punkrocker/Keyboards/README.md

# SweepPluck

34 键正交分体键盘，采用可翻面 PCB。两侧使用两片相同 PCB，在相反面装配。

本仓库仅包含 Pluck 版本。

- [工程、装配说明及验证结果](SweepPluck/README.txt)
- [主控焊接位置标记图](SweepPluck/mcu-guide/README.md)
- [电池与电源开关焊接图](SweepPluck/power-guide/README.md)
- [PCB 下单文件](SweepPluck/SweepPluck-JLCPCB.zip)
- [旅行便携盒](SweepPluck/travel-case/)
- [许可证](LICENSE)

设计基于 [Sweep](https://github.com/davidphilipbarr/Sweep)。Pluck 的历史设计归档保存在 `SweepPluck/archive/`。
