punkrocker/Keyboards/SweepPluck/travel-case/使用说明.txt

SweepPluck 旅行便携盒 — 裸 PCB / 3 mm 防滑垫修订版

设计依据
不使用键盘底壳，直接从当前 PCB 读取 95.25×80×1.6 mm 板框。
配置为 3 mm 防滑垫、Choc V2；按用户要求，用 Keychron K3 键帽高度替代原键帽模型。
采用 K3 兼容 LSA Version 1 键帽官方高度 4.4 mm：
https://www.keychron.com/products/low-profile-double-shot-pbt-keycap-set
这不是所有 K3 世代键帽的统一高度，也不是 Choc V2 与该键帽的适配验证。
主控：nice!nano，插座热插拔，按当前 PCB 说明元件面朝向 PCB（FACE DOWN）。
官方给出的模块总厚度为 3.2 mm：
https://nicekeyboards.com/docs/nice-nano/
插座具体型号尚未指定；设计暂以 PCB 上表面至模块最低外包络点 8.5 mm 的间距预算。
此数值不是排母本体高度，不等于实物安装距离；需包含实际引脚/插座造成的抬高。
按该预算，模块最高点距 PCB 上表面不超过 8.5+3.2=11.7 mm，
加 3 mm 垫和 1.6 mm PCB 后总高 16.3 mm，距 20 mm 腔顶余量 3.7 mm。
保留 1 mm 最低余量时，允许上述模块最低包络点间距最大 11.2 mm。
电池与接线如装在主控下方，须在同一空间内固定，不计为自动适配。

文件与尺寸（mm）
base.stl / lid.stl：上下半盒，合拢外形 108.05×92.80×44.80。
preview.png：几何预览。verification.json：来源、尺寸及网格检查。
foam_locator_1to1.svg：EVA 定位圈裁切模板，毫米单位，打印核对比例。
../tools/travel_case.py：生成器，不再依赖 case/ 的键盘底壳。
壁厚和底厚均 2.4，每半内腔 103.25×88，深度 20。
止口突出 1.6，径向配合间隙 0.30，净开口 100.25×85。
内腔比 PCB 每侧大 4 mm，接口实际外伸仍需核对。

内托与装配
用约 4 mm 厚 EVA 按模板制作两片环形内托，放在两半盒底。
外形约 102.85×87.60，内孔 96.05×80.80。
内孔容纳 PCB 及按板框裁切的 3 mm 防滑垫，每侧约 0.4 mm 间隙。
内托只属于收纳盒，不固定到键盘上；不需要打印键盘外壳。
不再额外叠加上一版的 1 mm 底垫。按软材料压缩情况试配，
可在 PCB 板边附近局部补薄软垫消除晃动，避让焊脚和接口。
防滑垫须绝缘，接触焊脚及轴体底部凸起的位置应开槽避让。
不要依赖强压软垫容纳凸起；确认凸起没有穿透防滑垫。
键盘防滑垫朝盒底，合拢时键帽相向；拔掉连接线后收纳。
另配 15～20 mm 宽魔术贴绑带。止口只定位，没有自锁功能。
开盒时扶住上半盒中的键盘；软内托不保证倒置锁住键盘。
软垫不可顶住键帽、主控、开关或接口；盒内不散放线材。

高度确认
测量从 3 mm 防滑垫底面至最高器件顶面的总高，包含主控及键帽。
本版高度预算：防滑垫 3 + PCB 1.6 + 轴体上方设计预留 10 + 键帽 4.4 = 19 mm。
10 mm 是保守的设计预留，不是厂商轴体尺寸；未扣除轴帽插接重叠量。
每半内腔 20 mm，预算余量各 1 mm，合拢面间余量合计至少 2 mm。
实际装配总高（含主控）须不超过 19 mm；主控最高点距 PCB 上表面须不超过 14.4 mm。
如超出，应加深盒子。最终腔深取实测总高加至少 1 mm。
键帽宽度、板边外伸、主控高度及接口外伸也需核对。
本版按授权的 K3 高度代理估算，尚未通过实物适配检查。

打印与重建
两件平底贴板、开口朝上、100% 比例，按实际打印机及耗材选预设。
起点：0.4 mm 喷嘴，0.20 mm 层高，4 道墙，5 层顶底，15～20% 填充。
检查止口根部约 1.5 mm 向内台阶桥接；一般无需支撑。
先试配止口，再打印完整件。STL 不包含已验证的切片配置。
从 D:/Projects/Sweep 执行：
python Sweep/SweepPluck/tools/travel_case.py --half-depth 20
--mcu-gap 8.5 可调整主控安装间距预算；超出高度余量时脚本要求加深盒子。
修改 half-depth 调整内部高度，覆盖模型、预览、裁切图及报告。
自定义参数后以 verification.json 为准，并同步更新本说明。

验证范围
两个模型均封闭、正体积、法向一致、单一连通；合盖相交体积为 0。
止口净开口大于 PCB 外形，未验证真实装配包围盒。
尚未实物试印，未验证指定轴帽、主控、接口、内托固定效果和抗压强度。
