punkrocker/Keyboards/SweepPluck/case/preview_trays.png

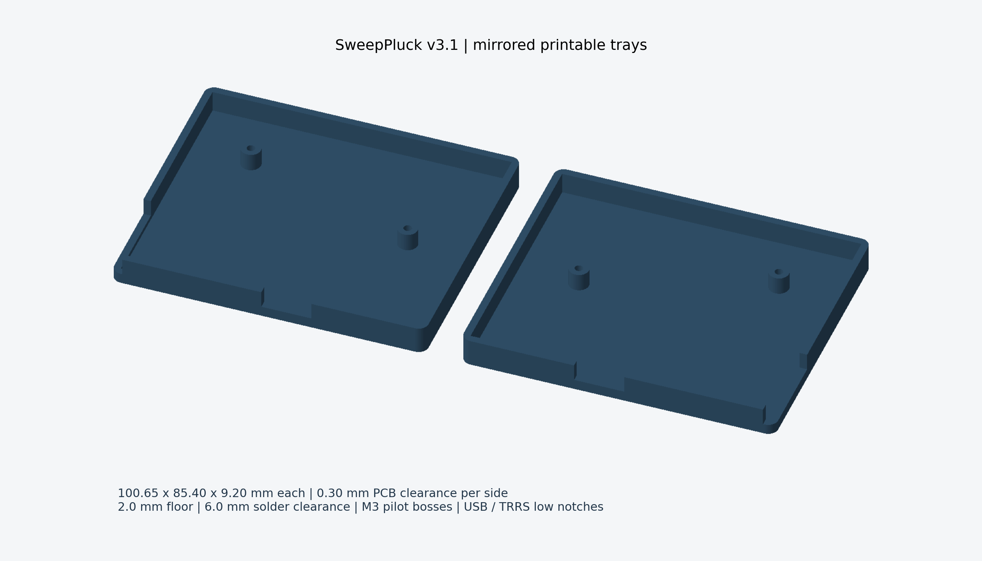
SweepPluck/case/preview_trays.png
