punkrocker/Keyboards/SweepPluck/SweepPluck-back-pcb.png

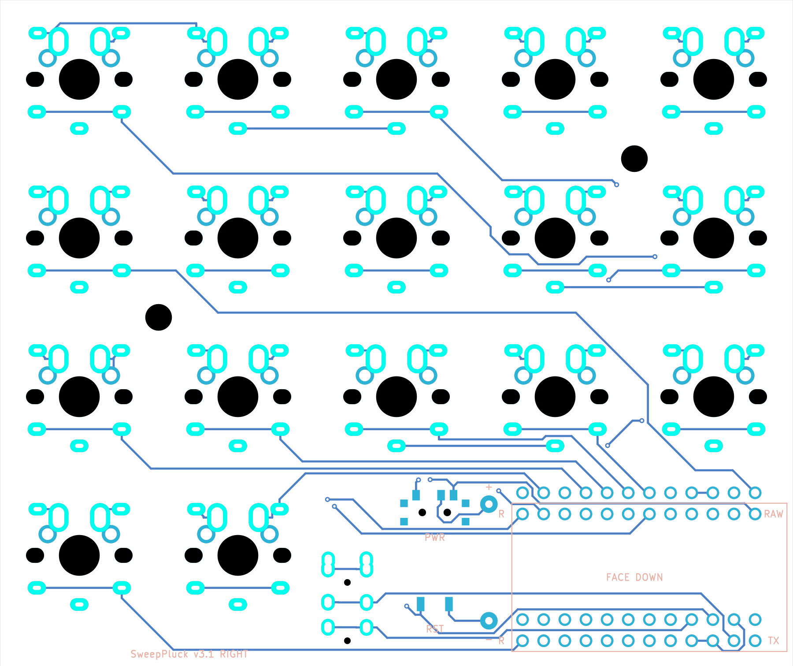
SweepPluck/SweepPluck-back-pcb.png
