punkrocker/Keyboards/SweepPluck/SweepPluck-plate-pcb.png

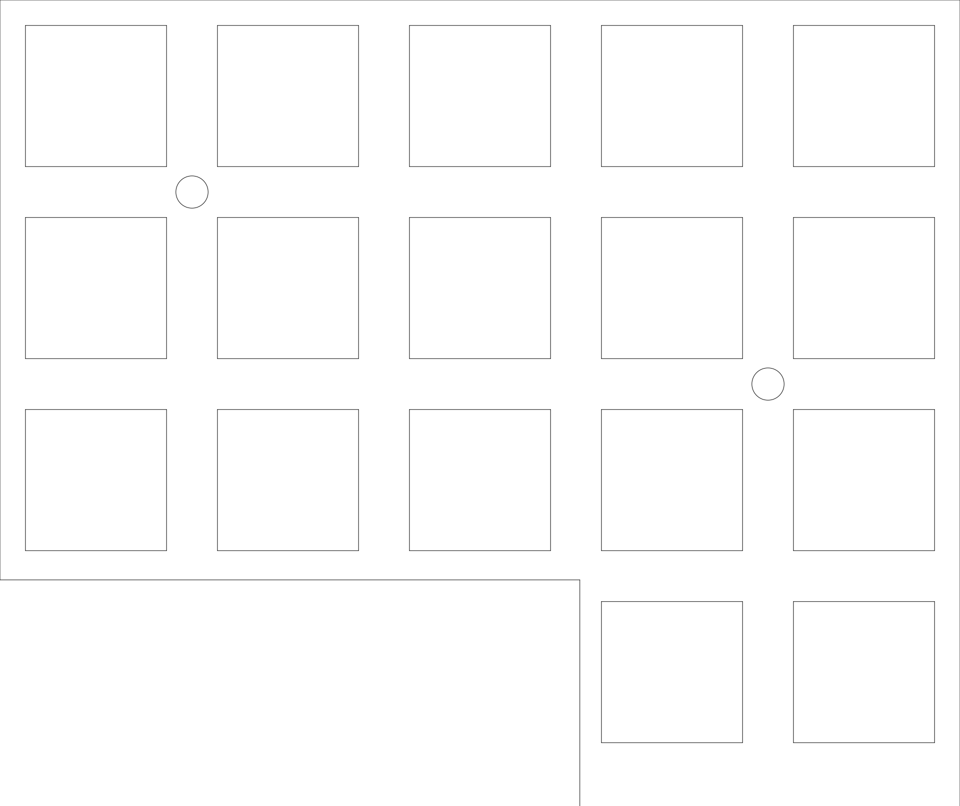
SweepPluck/SweepPluck-plate-pcb.png
