punkrocker/Keyboards/SweepPluck/SweepPluck-preview-pcb.png

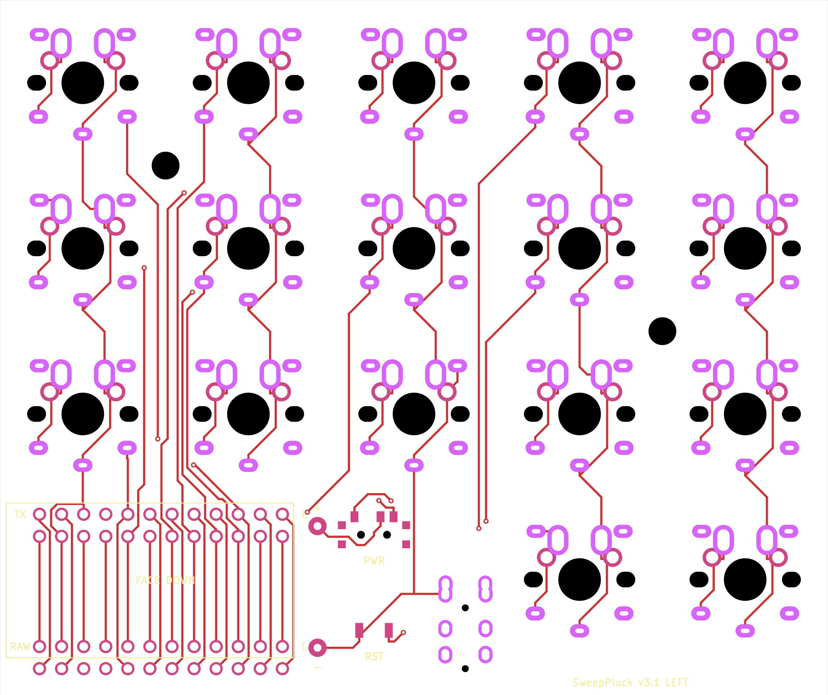
SweepPluck/SweepPluck-preview-pcb.png
