punkrocker/Keyboards/SweepPluck/SweepPluck-preview.png

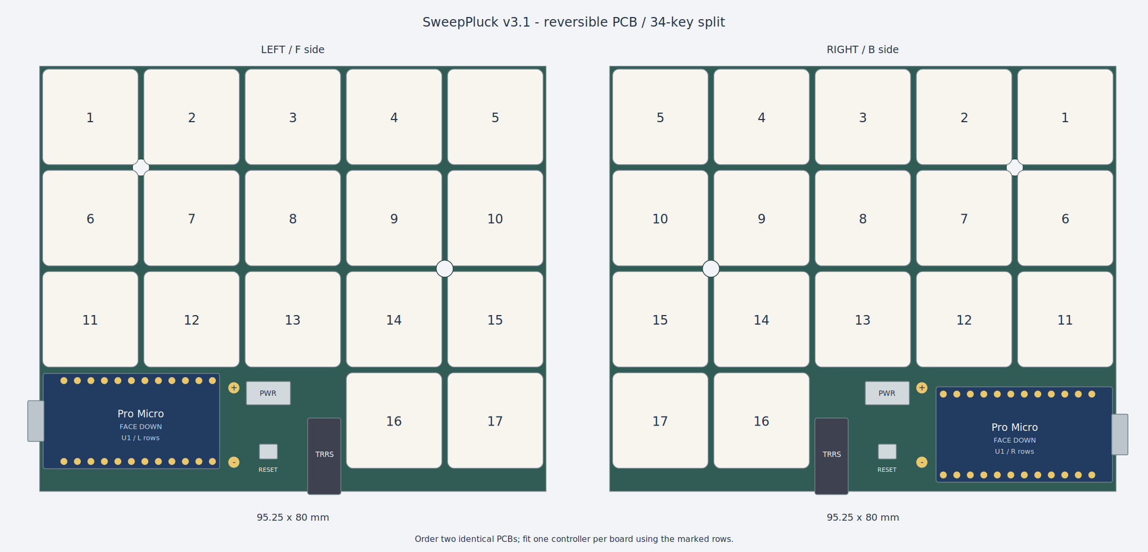
SweepPluck/SweepPluck-preview.png
