punkrocker/Keyboards/SweepPluck/travel-case/preview.png

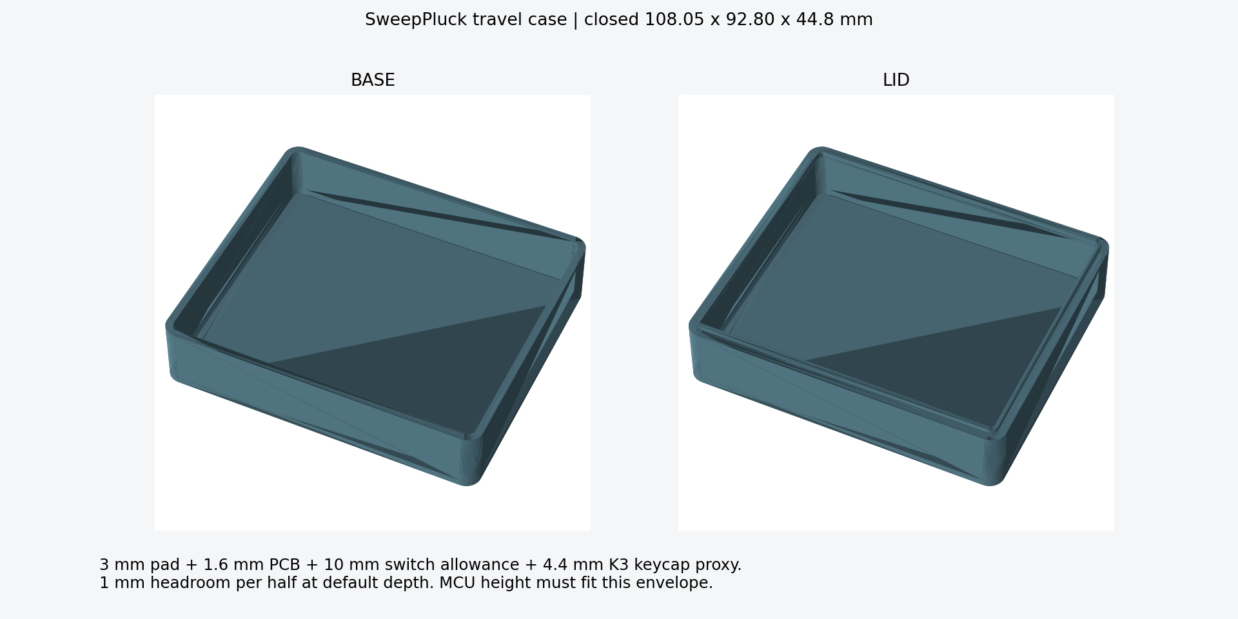
SweepPluck/travel-case/preview.png
