punkrocker/Keyboards/SweepPluck/SweepPluck-pins.csv

reference | pad | net | x_mm | y_mm | copper_layers | assembly | drill_x_mm | drill_y_mm
BATG1 | 1 | GND | 72.0 | 125.0 | F.Cu+B.Cu | BOTH | 0.9 | 0.9
BATP1 | 1 | BAT | 72.0 | 111.0 | F.Cu+B.Cu | BOTH | 0.9 | 0.9
J1 | R1 | SERIAL | 91.33 | 122.78 | F.Cu+B.Cu | BOTH | 0.9 | 1.3
J1 | R1 | SERIAL | 86.7 | 122.8 | F.Cu+B.Cu | BOTH | 0.9 | 1.3
J1 | R2 | VCC | 91.33 | 125.78 | F.Cu+B.Cu | BOTH | 0.9 | 1.3
J1 | R2 | VCC | 86.7 | 125.8 | F.Cu+B.Cu | BOTH | 0.9 | 1.3
J1 | S | GND | 91.3 | 117.7 | F.Cu+B.Cu | BOTH | 0.9 | 1.3
J1 | S | GND | 86.73 | 117.68 | F.Cu+B.Cu | BOTH | 0.9 | 1.3
J1 | T | GND | 91.33 | 118.78 | F.Cu+B.Cu | BOTH | 0.9 | 1.3
J1 | T | GND | 86.7 | 118.8 | F.Cu+B.Cu | BOTH | 0.9 | 1.3
RSW1 | 1 | GND | 76.8 | 123.0 | F.Cu | LEFT | 0.0 | 0.0
RSW1 | 1 | GND | 76.8 | 123.0 | B.Cu | RIGHT | 0.0 | 0.0
RSW1 | 2 | RESET | 80.2 | 123.0 | F.Cu | LEFT | 0.0 | 0.0
RSW1 | 2 | RESET | 80.2 | 123.0 | B.Cu | RIGHT | 0.0 | 0.0
SW1 | 1 | Switch1 | 39.9 | 63.9 | F.Cu+B.Cu | BOTH | 1.0 | 0.5
SW1 | 1 | Switch1 | 40.0 | 54.45 | F.Cu+B.Cu | BOTH | 1.0 | 0.5
SW1 | 1 | Switch1 | 41.2 | 57.45 | F.Cu+B.Cu | BOTH | 1.4 | 1.4
SW1 | 1 | Switch1 | 42.5 | 55.4625 | F.Cu+B.Cu | BOTH | 1.4 | 2.475
SW1 | 1 | Switch1 | 50.1 | 63.9 | F.Cu+B.Cu | BOTH | 1.0 | 0.5
SW1 | 2 | GND | 45.0 | 65.9 | F.Cu+B.Cu | BOTH | 1.0 | 0.5
SW1 | 2 | GND | 47.5 | 55.4625 | F.Cu+B.Cu | BOTH | 1.4 | 2.475
SW1 | 2 | GND | 48.8 | 57.45 | F.Cu+B.Cu | BOTH | 1.4 | 1.4
SW1 | 2 | GND | 50.0 | 54.45 | F.Cu+B.Cu | BOTH | 1.0 | 0.5
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
SW6 | 1 | Switch6 | 41.2 | 76.5 | F.Cu+B.Cu | BOTH | 1.4 | 1.4
SW6 | 1 | Switch6 | 42.5 | 74.5125 | F.Cu+B.Cu | BOTH | 1.4 | 2.475
SW6 | 1 | Switch6 | 50.1 | 82.95 | F.Cu+B.Cu | BOTH | 1.0 | 0.5
SW6 | 2 | GND | 45.0 | 84.95 | F.Cu+B.Cu | BOTH | 1.0 | 0.5
SW6 | 2 | GND | 47.5 | 74.5125 | F.Cu+B.Cu | BOTH | 1.4 | 2.475
SW6 | 2 | GND | 48.8 | 76.5 | F.Cu+B.Cu | BOTH | 1.4 | 1.4
SW6 | 2 | GND | 50.0 | 73.5 | F.Cu+B.Cu | BOTH | 1.0 | 0.5
SW7 | 1 | Switch7 | 58.95 | 82.95 | F.Cu+B.Cu | BOTH | 1.0 | 0.5
SW7 | 1 | Switch7 | 59.05 | 73.5 | F.Cu+B.Cu | BOTH | 1.0 | 0.5
SW7 | 1 | Switch7 | 60.25 | 76.5 | F.Cu+B.Cu | BOTH | 1.4 | 1.4
SW7 | 1 | Switch7 | 61.55 | 74.5125 | F.Cu+B.Cu | BOTH | 1.4 | 2.475
SW7 | 1 | Switch7 | 69.15 | 82.95 | F.Cu+B.Cu | BOTH | 1.0 | 0.5
SW7 | 2 | GND | 64.05 | 84.95 | F.Cu+B.Cu | BOTH | 1.0 | 0.5
SW7 | 2 | GND | 66.55 | 74.5125 | F.Cu+B.Cu | BOTH | 1.4 | 2.475
SW7 | 2 | GND | 67.85 | 76.5 | F.Cu+B.Cu | BOTH | 1.4 | 1.4
SW7 | 2 | GND | 69.05 | 73.5 | F.Cu+B.Cu | BOTH | 1.0 | 0.5
SW8 | 1 | Switch8 | 78.0 | 82.95 | F.Cu+B.Cu | BOTH | 1.0 | 0.5
SW8 | 1 | Switch8 | 78.1 | 73.5 | F.Cu+B.Cu | BOTH | 1.0 | 0.5
SW8 | 1 | Switch8 | 79.3 | 76.5 | F.Cu+B.Cu | BOTH | 1.4 | 1.4
SW8 | 1 | Switch8 | 80.6 | 74.5125 | F.Cu+B.Cu | BOTH | 1.4 | 2.475
SW8 | 1 | Switch8 | 88.2 | 82.95 | F.Cu+B.Cu | BOTH | 1.0 | 0.5
SW8 | 2 | GND | 83.1 | 84.95 | F.Cu+B.Cu | BOTH | 1.0 | 0.5
SW8 | 2 | GND | 85.6 | 74.5125 | F.Cu+B.Cu | BOTH | 1.4 | 2.475
SW8 | 2 | GND | 86.9 | 76.5 | F.Cu+B.Cu | BOTH | 1.4 | 1.4
SW8 | 2 | GND | 88.1 | 73.5 | F.Cu+B.Cu | BOTH | 1.0 | 0.5
SW9 | 1 | Switch9 | 97.05 | 82.95 | F.Cu+B.Cu | BOTH | 1.0 | 0.5
SW9 | 1 | Switch9 | 97.15 | 73.5 | F.Cu+B.Cu | BOTH | 1.0 | 0.5
SW9 | 1 | Switch9 | 98.35 | 76.5 | F.Cu+B.Cu | BOTH | 1.4 | 1.4
SW9 | 1 | Switch9 | 99.65 | 74.5125 | F.Cu+B.Cu | BOTH | 1.4 | 2.475
SW9 | 1 | Switch9 | 107.25 | 82.95 | F.Cu+B.Cu | BOTH | 1.0 | 0.5
SW9 | 2 | GND | 102.15 | 84.95 | F.Cu+B.Cu | BOTH | 1.0 | 0.5
SW9 | 2 | GND | 104.65 | 74.5125 | F.Cu+B.Cu | BOTH | 1.4 | 2.475
SW9 | 2 | GND | 105.95 | 76.5 | F.Cu+B.Cu | BOTH | 1.4 | 1.4
SW9 | 2 | GND | 107.15 | 73.5 | F.Cu+B.Cu | BOTH | 1.0 | 0.5
SW_POWER1 | 1 | unconnected-(SW_POWER1-Pad1) | 76.25 | 109.925 | F.Cu | LEFT | 0.0 | 0.0
SW_POWER1 | 1 | unconnected-(SW_POWER1-Pad1) | 80.75 | 109.925 | B.Cu | RIGHT | 0.0 | 0.0
SW_POWER1 | 2 | BAT | 77.75 | 109.925 | B.Cu | RIGHT | 0.0 | 0.0
SW_POWER1 | 2 | BAT | 79.25 | 109.925 | F.Cu | LEFT | 0.0 | 0.0
SW_POWER1 | 3 | RAW | 76.25 | 109.925 | B.Cu | RIGHT | 0.0 | 0.0
SW_POWER1 | 3 | RAW | 80.75 | 109.925 | F.Cu | LEFT | 0.0 | 0.0
U1 | 1 | Switch10 | 40.022 | 109.6386 | F.Cu+B.Cu | LEFT | 1.0 | 1.0
U1 | 1 | Switch10 | 40.022 | 127.4014 | F.Cu+B.Cu | RIGHT | 1.0 | 1.0
U1 | 2 | SERIAL | 42.562 | 109.6386 | F.Cu+B.Cu | LEFT | 1.0 | 1.0
U1 | 2 | SERIAL | 42.562 | 127.4014 | F.Cu+B.Cu | RIGHT | 1.0 | 1.0
U1 | 3 | GND | 45.102 | 109.6386 | F.Cu+B.Cu | LEFT | 1.0 | 1.0
U1 | 3 | GND | 45.102 | 127.4014 | F.Cu+B.Cu | RIGHT | 1.0 | 1.0
U1 | 4 | GND | 47.642001 | 109.6386 | F.Cu+B.Cu | LEFT | 1.0 | 1.0
U1 | 4 | GND | 47.642001 | 127.4014 | F.Cu+B.Cu | RIGHT | 1.0 | 1.0
U1 | 5 | Switch11 | 50.182001 | 109.6386 | F.Cu+B.Cu | LEFT | 1.0 | 1.0
U1 | 5 | Switch11 | 50.182001 | 127.4014 | F.Cu+B.Cu | RIGHT | 1.0 | 1.0
U1 | 6 | Switch12 | 52.722001 | 109.6386 | F.Cu+B.Cu | LEFT | 1.0 | 1.0
U1 | 6 | Switch12 | 52.722001 | 127.4014 | F.Cu+B.Cu | RIGHT | 1.0 | 1.0
U1 | 7 | Switch13 | 55.262 | 109.6386 | F.Cu+B.Cu | LEFT | 1.0 | 1.0
U1 | 7 | Switch13 | 55.262 | 127.4014 | F.Cu+B.Cu | RIGHT | 1.0 | 1.0
U1 | 8 | Switch14 | 57.801999 | 109.6386 | F.Cu+B.Cu | LEFT | 1.0 | 1.0
U1 | 8 | Switch14 | 57.801999 | 127.4014 | F.Cu+B.Cu | RIGHT | 1.0 | 1.0
U1 | 9 | Switch15 | 60.341999 | 109.6386 | F.Cu+B.Cu | LEFT | 1.0 | 1.0
U1 | 9 | Switch15 | 60.341999 | 127.4014 | F.Cu+B.Cu | RIGHT | 1.0 | 1.0
U1 | 10 | Switch1 | 62.881999 | 109.6386 | F.Cu+B.Cu | LEFT | 1.0 | 1.0
U1 | 10 | Switch1 | 62.881999 | 127.4014 | F.Cu+B.Cu | RIGHT | 1.0 | 1.0
U1 | 11 | Switch16 | 65.421999 | 109.6386 | F.Cu+B.Cu | LEFT | 1.0 | 1.0
U1 | 11 | Switch16 | 65.421999 | 127.4014 | F.Cu+B.Cu | RIGHT | 1.0 | 1.0
U1 | 12 | Switch17 | 67.962 | 109.6386 | F.Cu+B.Cu | LEFT | 1.0 | 1.0
U1 | 12 | Switch17 | 67.962 | 127.4014 | F.Cu+B.Cu | RIGHT | 1.0 | 1.0
U1 | 13 | Switch9 | 67.962 | 112.181401 | F.Cu+B.Cu | RIGHT | 1.0 | 1.0
U1 | 13 | Switch9 | 67.962 | 124.858599 | F.Cu+B.Cu | LEFT | 1.0 | 1.0
U1 | 14 | Switch8 | 65.421999 | 112.181401 | F.Cu+B.Cu | RIGHT | 1.0 | 1.0
U1 | 14 | Switch8 | 65.421999 | 124.858599 | F.Cu+B.Cu | LEFT | 1.0 | 1.0
U1 | 15 | Switch7 | 62.881999 | 112.181401 | F.Cu+B.Cu | RIGHT | 1.0 | 1.0
U1 | 15 | Switch7 | 62.881999 | 124.858599 | F.Cu+B.Cu | LEFT | 1.0 | 1.0
U1 | 16 | Switch6 | 60.341999 | 112.181401 | F.Cu+B.Cu | RIGHT | 1.0 | 1.0
U1 | 16 | Switch6 | 60.341999 | 124.858599 | F.Cu+B.Cu | LEFT | 1.0 | 1.0
U1 | 17 | Switch2 | 57.801999 | 112.181401 | F.Cu+B.Cu | RIGHT | 1.0 | 1.0
U1 | 17 | Switch2 | 57.801999 | 124.858599 | F.Cu+B.Cu | LEFT | 1.0 | 1.0
U1 | 18 | Switch3 | 55.262 | 112.181401 | F.Cu+B.Cu | RIGHT | 1.0 | 1.0
U1 | 18 | Switch3 | 55.262 | 124.858599 | F.Cu+B.Cu | LEFT | 1.0 | 1.0
U1 | 19 | Switch4 | 52.722001 | 112.181401 | F.Cu+B.Cu | RIGHT | 1.0 | 1.0
U1 | 19 | Switch4 | 52.722001 | 124.858599 | F.Cu+B.Cu | LEFT | 1.0 | 1.0
U1 | 20 | Switch5 | 50.182001 | 112.181401 | F.Cu+B.Cu | RIGHT | 1.0 | 1.0
U1 | 20 | Switch5 | 50.182001 | 124.858599 | F.Cu+B.Cu | LEFT | 1.0 | 1.0
U1 | 21 | VCC | 47.642001 | 112.181401 | F.Cu+B.Cu | RIGHT | 1.0 | 1.0
U1 | 21 | VCC | 47.642001 | 124.858599 | F.Cu+B.Cu | LEFT | 1.0 | 1.0
U1 | 22 | RESET | 45.102 | 112.181401 | F.Cu+B.Cu | RIGHT | 1.0 | 1.0
U1 | 22 | RESET | 45.102 | 124.858599 | F.Cu+B.Cu | LEFT | 1.0 | 1.0
U1 | 23 | GND | 42.562 | 112.181401 | F.Cu+B.Cu | RIGHT | 1.0 | 1.0
U1 | 23 | GND | 42.562 | 124.858599 | F.Cu+B.Cu | LEFT | 1.0 | 1.0
U1 | 24 | RAW | 40.022 | 112.181401 | F.Cu+B.Cu | RIGHT | 1.0 | 1.0
U1 | 24 | RAW | 40.022 | 124.858599 | F.Cu+B.Cu | LEFT | 1.0 | 1.0
