punkrocker/Keyboards/SweepPluck/case/SweepPluck_trays_P2S.3mf

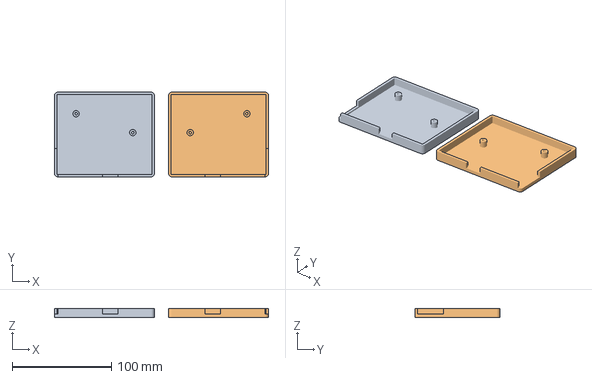
[picture p7: CAD file, 2026-10-18]
SweepPluck/case/SweepPluck_trays_P2S.3mf
215.6 x 85.4 x 9.20 mm
left_tray
right_tray
