punkrocker/Keyboards/SweepPluck/SweepPluck-plate.dxf

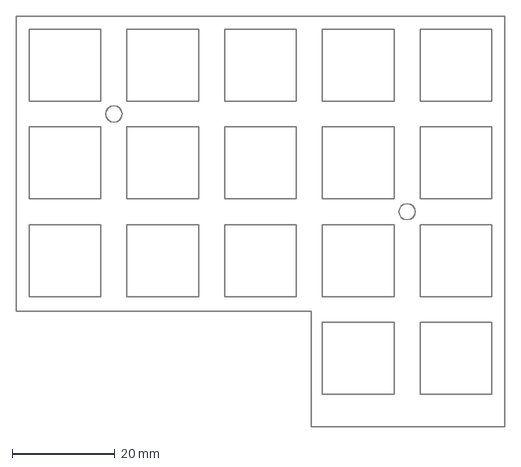
[picture p8: CAD file, 2026-10-18]
SweepPluck/SweepPluck-plate.dxf
95.2 x 80.0 mm
