punkrocker/Keyboards/SweepPluck/travel-case/base.stl

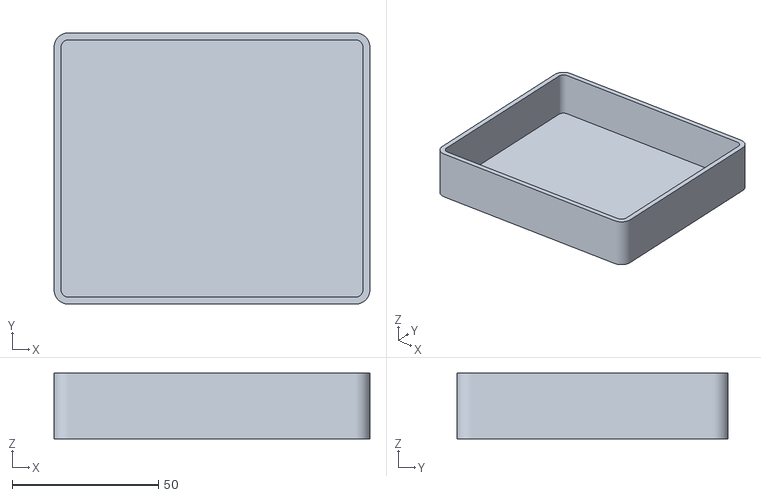
[picture p9: CAD file, 2026-10-18]
SweepPluck/travel-case/base.stl
108.1 x 92.8 x 22.4
