punkrocker/Keyboards/SweepPluck/case/SweepPluck_plates_optional.3mf

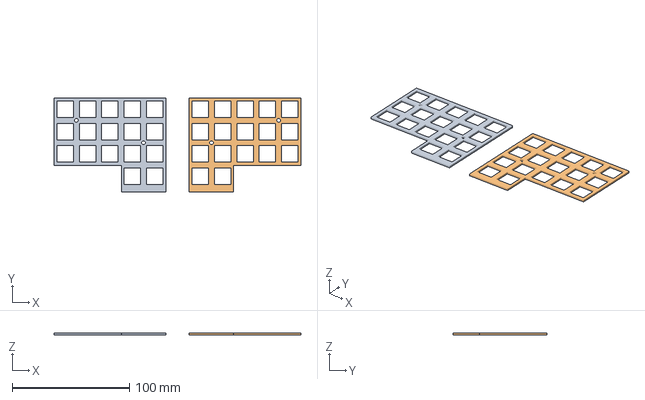
[picture p10: CAD file, 2026-10-18]
SweepPluck/case/SweepPluck_plates_optional.3mf
210.2 x 80.0 x 1.60 mm
left_plate_optional
right_plate_optional
