punkrocker/Keyboards/SweepPluck/travel-case/lid.stl

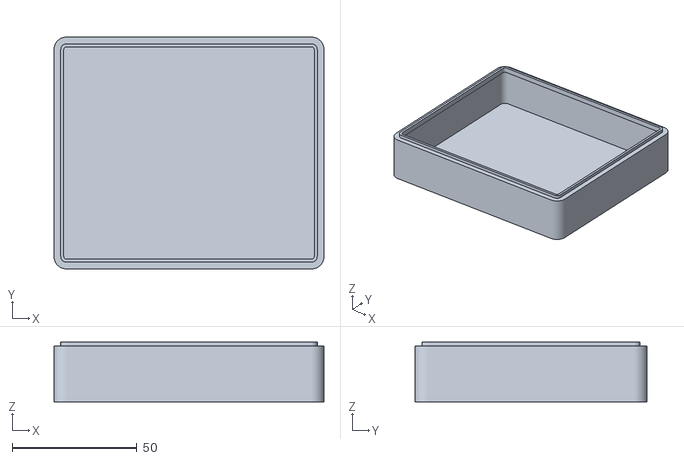
[picture p11: CAD file, 2026-10-18]
SweepPluck/travel-case/lid.stl
108.1 x 92.8 x 24.0
