punkrocker/Keyboards/SweepPluck/case/left_tray.stl

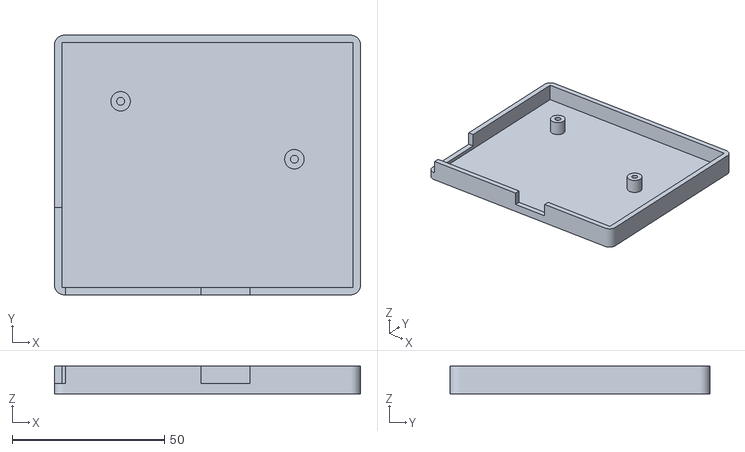
[picture p12: CAD file, 2026-10-18]
SweepPluck/case/left_tray.stl
100.6 x 85.4 x 9.20
