punkrocker/Keyboards/SweepPluck/case/right_plate_optional.stl

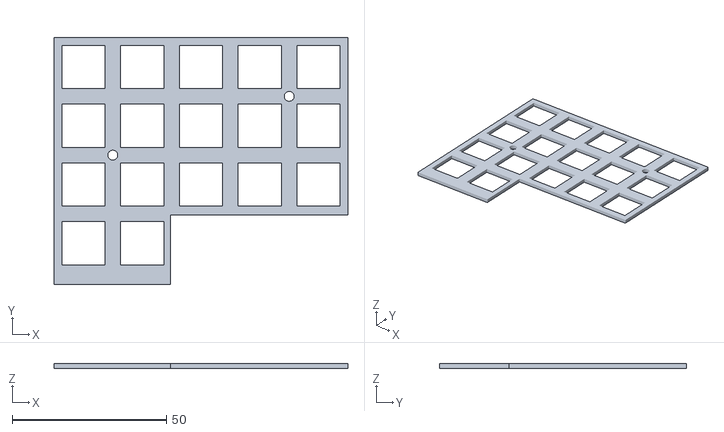
[picture p13: CAD file, 2026-10-18]
SweepPluck/case/right_plate_optional.stl
95.2 x 80.0 x 1.60
