punkrocker/Keyboards/SweepPluck/case/screw_fit_coupon.stl

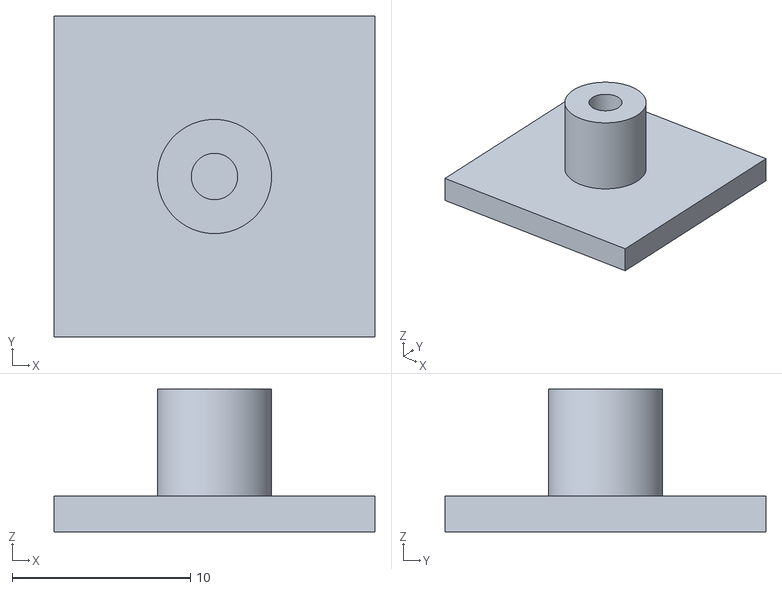
[picture p14: CAD file, 2026-10-18]
SweepPluck/case/screw_fit_coupon.stl
18.0 x 18.0 x 8.00
