punkrocker/Keyboards/SweepPluck/archive/obsolete/plate-left.dxf

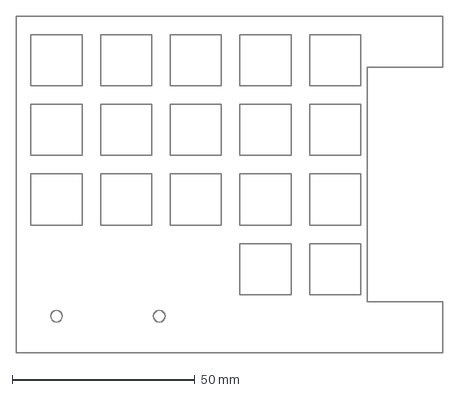
[picture p15: CAD file, 2026-10-18, an earlier design]
SweepPluck/archive/obsolete/plate-left.dxf
116.6 x 92.0 mm
