punkrocker/Keyboards/SweepPluck/archive/obsolete/plate-right.dxf

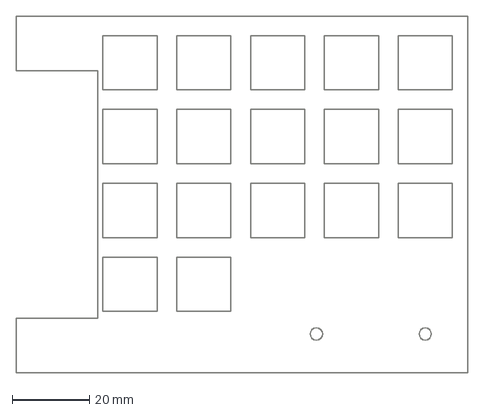
[picture p16: CAD file, 2026-10-18, an earlier design]
SweepPluck/archive/obsolete/plate-right.dxf
116.6 x 92.0 mm
