punkrocker/Keyboards/(list of files, cad)

Other CAD files:
SweepPluck/case/right_tray.stl
SweepPluck/case/left_plate_optional.stl
