punkrocker/Keyboards/SweepPluck/case/打印与装配说明.txt

SweepPluck v3.1 开放式底壳 — 拓竹 P2S
====================================

文件选择
SweepPluck_trays_P2S.3mf：左右底壳，已按毫米单位分开放置在同一打印盘。
left_tray.stl / right_tray.stl：可单独导入的同款模型，底面已经放到 Z=0。
SweepPluck_plates_optional.3mf：可选左右定位板，1.6 mm 厚、14×14 mm 轴孔。
left_plate_optional.stl / right_plate_optional.stl：可选定位板单件。
screw_fit_coupon.stl：18×18 mm 螺丝柱试印件，先检验 M3 螺丝配合。
preview_trays.png：实际打印底壳几何预览。
preview_assembly.png：底壳配合 PCB、简化轴体键帽和主控的装配示意。
verification.json：尺寸、网格检查与来源 PCB/定位板哈希。

结构与尺寸
依据当前 SweepPluck.kicad_pcb 的 95.25×80 mm 板框及 H1/H2 两个安装孔。
PCB 厚度按仓库规定的 1.6 mm；右手按 PCB 翻面后的左右镜像设计。
单壳外形 100.65×85.40×9.20 mm，圆角半径 3.2 mm。
腔体 95.85×80.60 mm，即板边每侧间隙 0.30 mm。
底板厚 2 mm，侧壁 2.4 mm；PCB 下表面位于外底面上方 8 mm。
焊接侧净高 6 mm，焊脚应修剪，实际装配建议留至少 1 mm 余量。
两个固定柱外径 6.4 mm，盲孔直径 2.6 mm，孔底 Z=2.5 mm。
左壳安装孔以 PCB 左下角为原点：H1=(19.05,60.95)，H2=(76.20,41.90) mm。
右壳沿 PCB 中心线镜像；STL 导出时另外平移至非负坐标。
侧壁最高 Z=9.2 mm，低于 PCB 上表面 Z=9.6 mm。
USB 外侧和 TRRS 前侧局部墙高降低到 3.5 mm，方便插座和插头伸出。
采用开放顶面，主控、电源及复位直接可操作。此设计没有主控上盖或防尘盖。

Bambu Studio 操作
1. 导入 SweepPluck_trays_P2S.3mf；若询问导入方式，按模型导入。
2. 选择自己的 P2S、实际喷嘴、打印板和耗材预设。
3. 作为初次试印起点：0.4 mm 喷嘴、0.20 mm 层高、4 层墙、
   5 层顶部/底部、15% gyroid 填充。温度和流量使用耗材已校准预设。
4. 两件保持开口朝上、平底贴板，100% 比例；无需支撑。
5. 通常不需要 brim；如材料翘曲，可加 3～5 mm 外侧 brim。
6. 切片后检查首层、两个螺丝盲孔、接口缺口；再发送打印或导出机器文件。
   3MF 是通用几何模型包，不包含已验证的 P2S 工艺配置或切片/G-code。
   尚未在 Bambu Studio 或实机中测试，不能直接当作已切片任务发送。
7. 可选定位板平放、0.20 mm 层高、100% 填充、无需支撑。
   它从原定位板轮廓生成，不包含主控区域，也不与底壳一体打印。

装配
建议先打印 screw_fit_coupon，再打印一侧底壳验证实板装配。
使用 4 枚 M3×6 mm 低头机螺丝（每侧两枚），建议头部直径不超过 5.5 mm、
高度不超过 1.5 mm；确认不碰邻近键帽的完整行程。
2.6 mm 盲孔用于在塑料中预攻 M3 螺纹或小心手动成形，不是热熔螺母孔。
M3×6 穿过 1.6 mm PCB 后进入柱内约 4.4 mm，理论距离盲孔底约 1.1 mm。
先在试件验证，不要用电动工具强拧；若改用不同螺丝长度，重新检查孔底余量。
主控和轴体应按仓库 README.txt 规定装配在键轴所在面。
左手 F 面朝上，使用 L 孔排；右手 B 面朝上，使用 R 孔排。
将装配好的 PCB 放入对应底壳，先检查焊脚、USB、TRRS 和插头，再锁螺丝。
每侧底面贴 4 个自行准备的防滑脚垫；壳体没有脚垫凹槽。

可选定位板：底壳可以独立使用。若轴体需要定位板，应按照实际轴体的定位板
到 PCB 距离，自备绝缘隔柱及相应长度螺丝；螺丝可从定位板穿过隔柱与 PCB
进入底壳固定柱。M3×6 仅适用于直接固定 PCB，不适用于加装隔柱后的整套叠层。
固定柱孔的有效深度只有 5.5 mm，应按实际叠层计算，保留孔底余量。
14×14 mm 开口仅针对适配该尺寸的 MX/Choc；Alps 需要另改开口。
不同轴体卡扣、键帽和 FDM 孔尺寸补偿需实际试装；没有把某一种轴体高度当作通用高度。

验证范围
所有打印件已通过封闭性、法向一致性、单一连通实体和正体积检查。
已检查单件与排版不超出 P2S 官方 256×256×256 mm 打印空间。
机械模型与 PCB 的板框及安装孔来自本地工程。
尚未实物试印，尚未验证具体主控插座、插头护套、键帽行程和打印收缩。
6 mm 底部空间主要供焊脚使用，没有指定电池仓或电池固定结构。
预览中的主控和键帽是简化参考体，不是精确供应商 STEP 模型，也不在打印文件中。

修改与重建
生成器：../tools/case.py；可修改 CLEAR/WALL/FLOOR/SEAT/HEIGHT/PILOT 参数。
依赖：numpy shapely trimesh manifold3d sexpdata mapbox-earcut matplotlib。
从 Sweep 仓库目录执行 python SweepPluck/tools/case.py。
修改 PCB 后应重新生成并核对，不要沿用旧壳尺寸。
来源授权沿用 ../LICENSE。
P2S 官方打印空间来源：
https://blog.bambulab.com/the-icon-redefined-meet-the-p2s-a-completely-reengineered-version-of-the-ultra-productive-p1-series/
