punkrocker/Keyboards/SweepPluck/case/preview_assembly.png

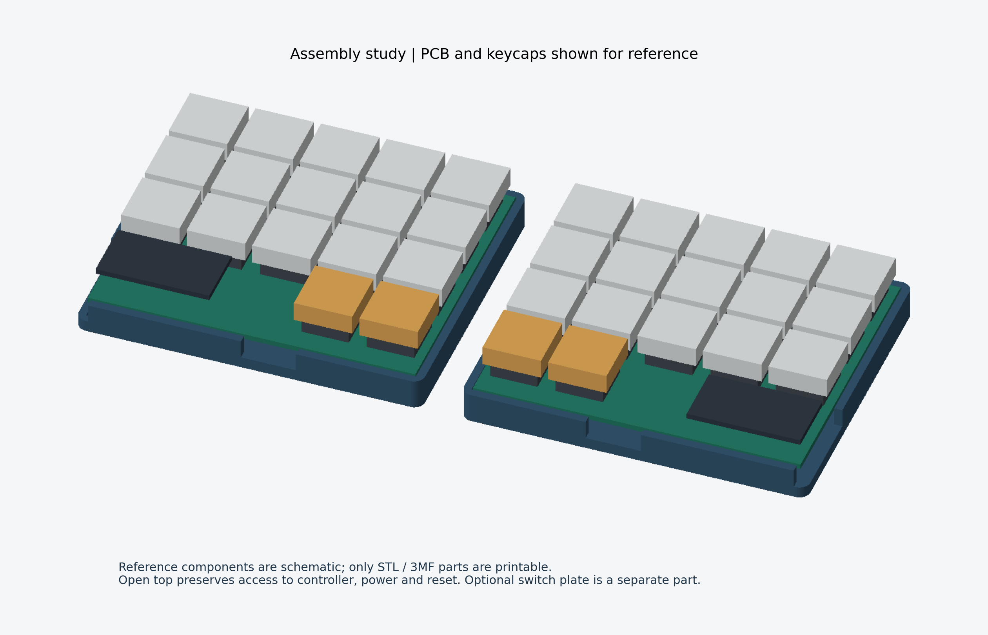
SweepPluck/case/preview_assembly.png
