punkrocker/Keyboards/SweepPluck/mx-guide/MX_back_RIGHT.png

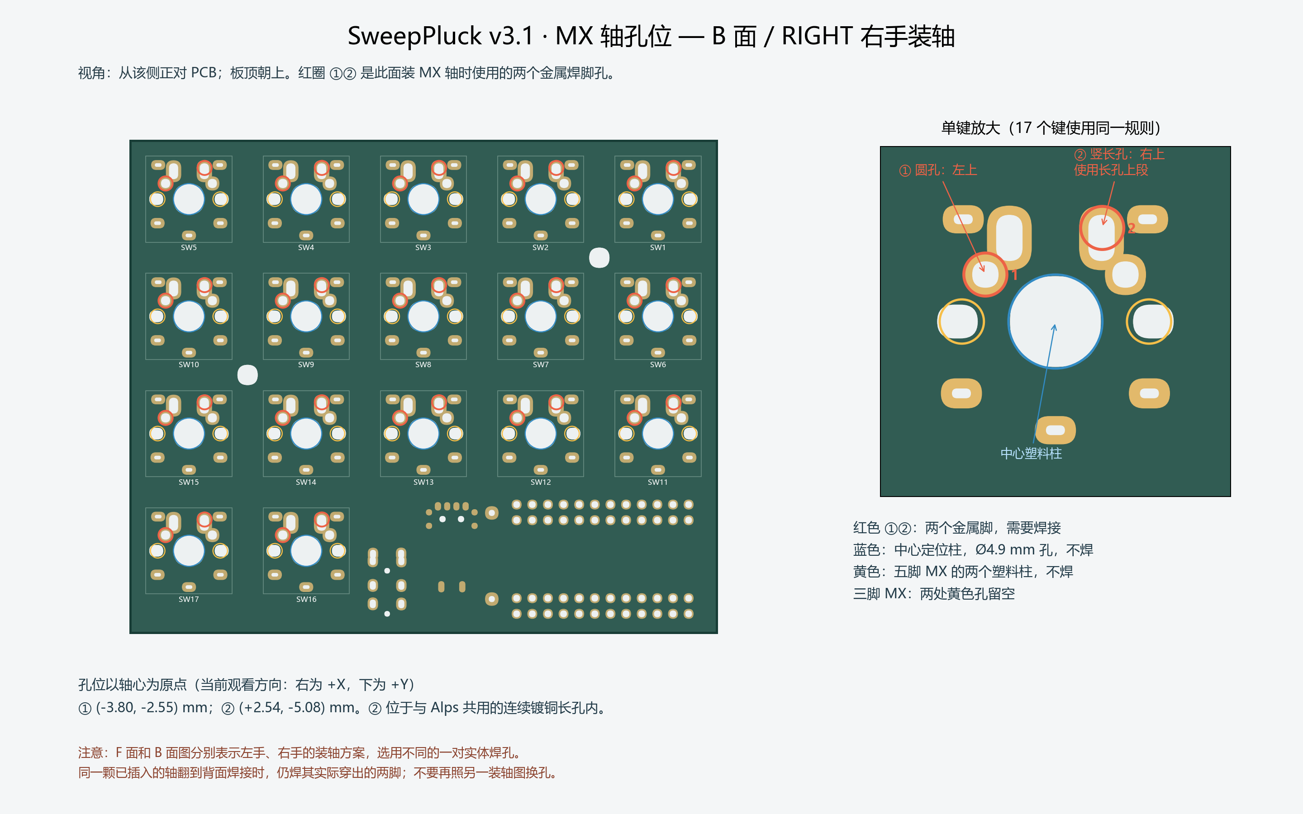
SweepPluck/mx-guide/MX_back_RIGHT.png
