punkrocker/Keyboards/SweepPluck/mx-guide/MX_front_LEFT.png

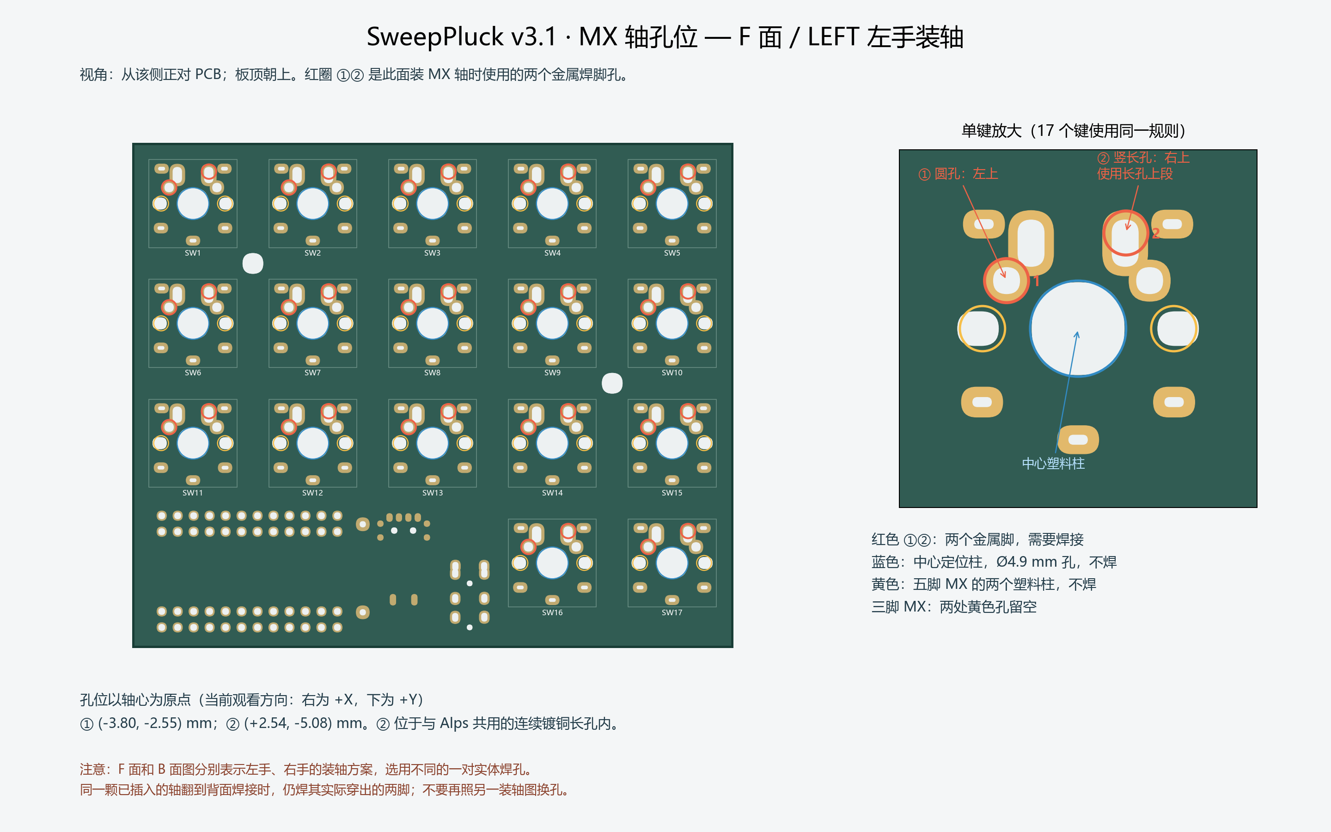
SweepPluck/mx-guide/MX_front_LEFT.png
