punkrocker/Keyboards/SweepPluck/power-guide/power_LEFT.png

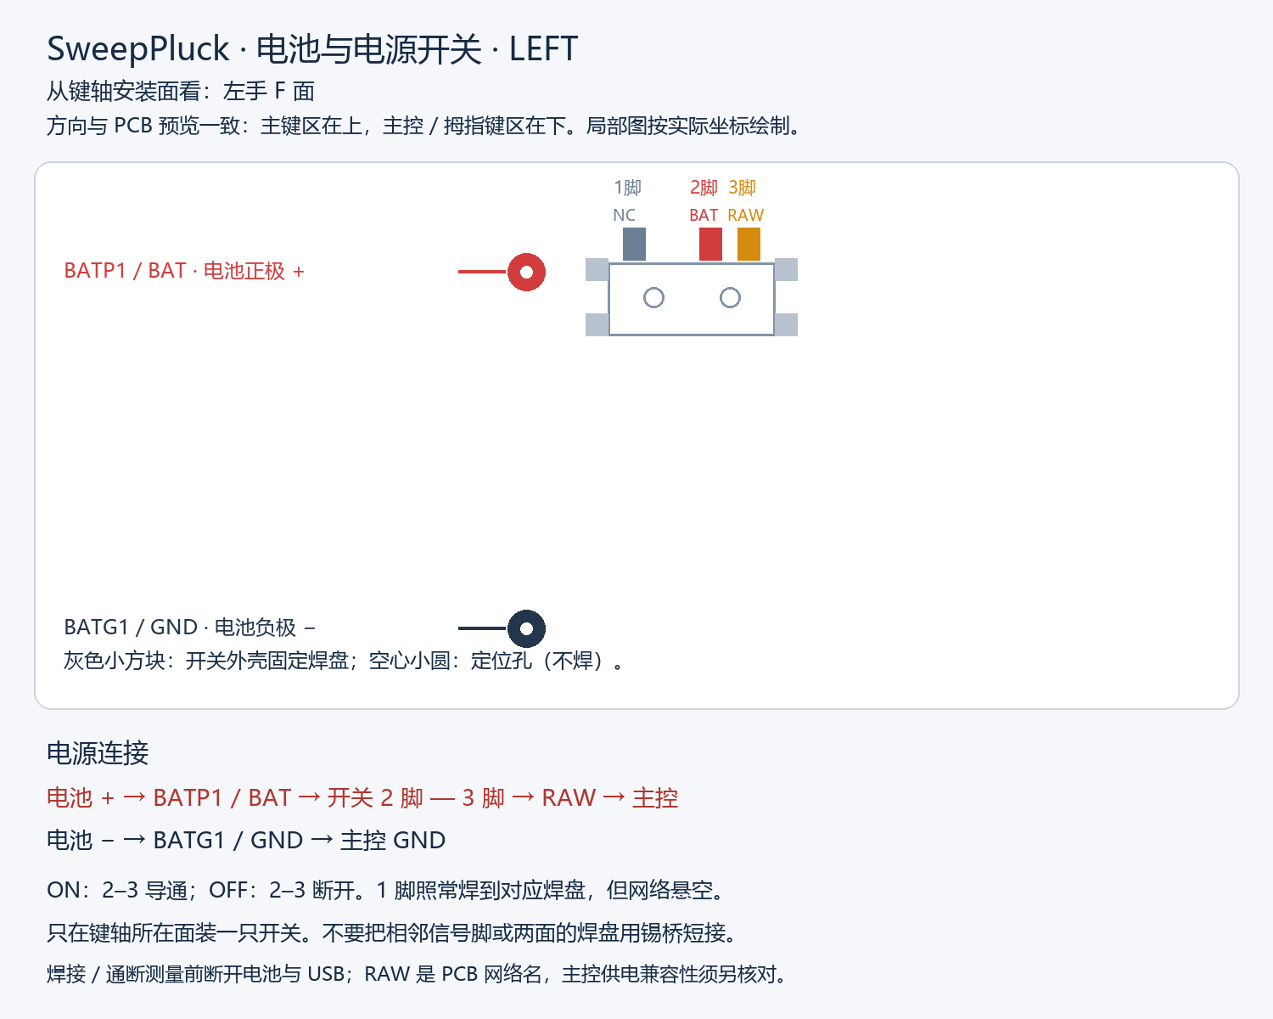
SweepPluck/power-guide/power_LEFT.png
