punkrocker/Keyboards/SweepPluck/power-guide/power_RIGHT.png

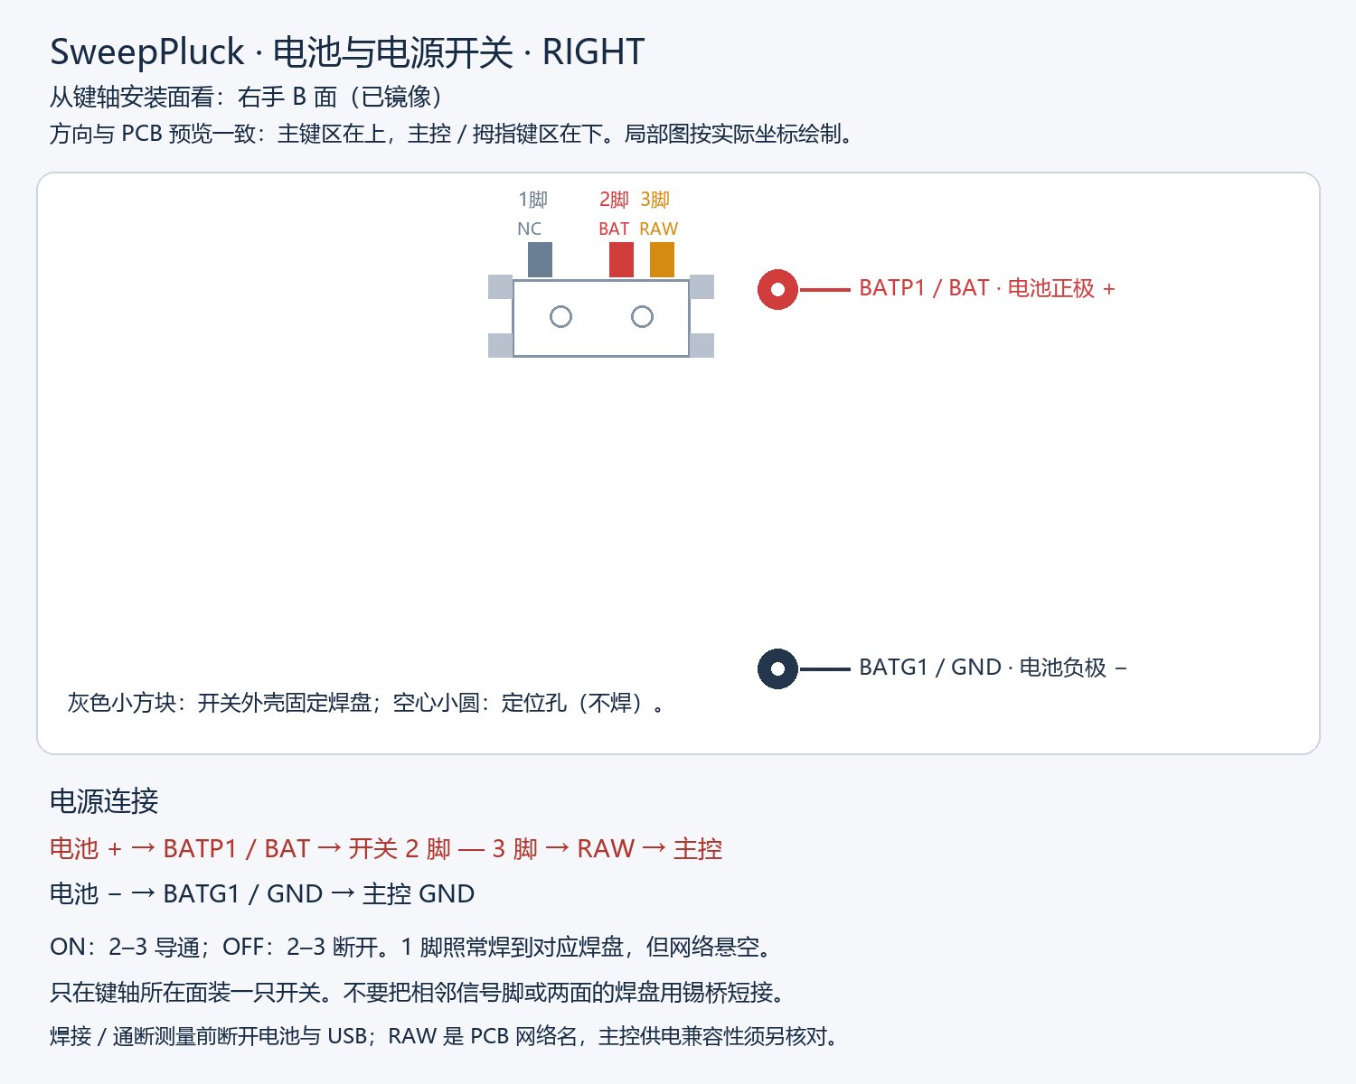
SweepPluck/power-guide/power_RIGHT.png
