punkrocker/Keyboards/(list of files, drawings)

Other design files:
SweepPluck/verification/SweepPluck.dsn
