punkrocker/Keyboards/SweepPluck/SweepPluck.kicad_pcb

## KiCad design SweepPluck/SweepPluck.kicad_pcb (2026-10-18)

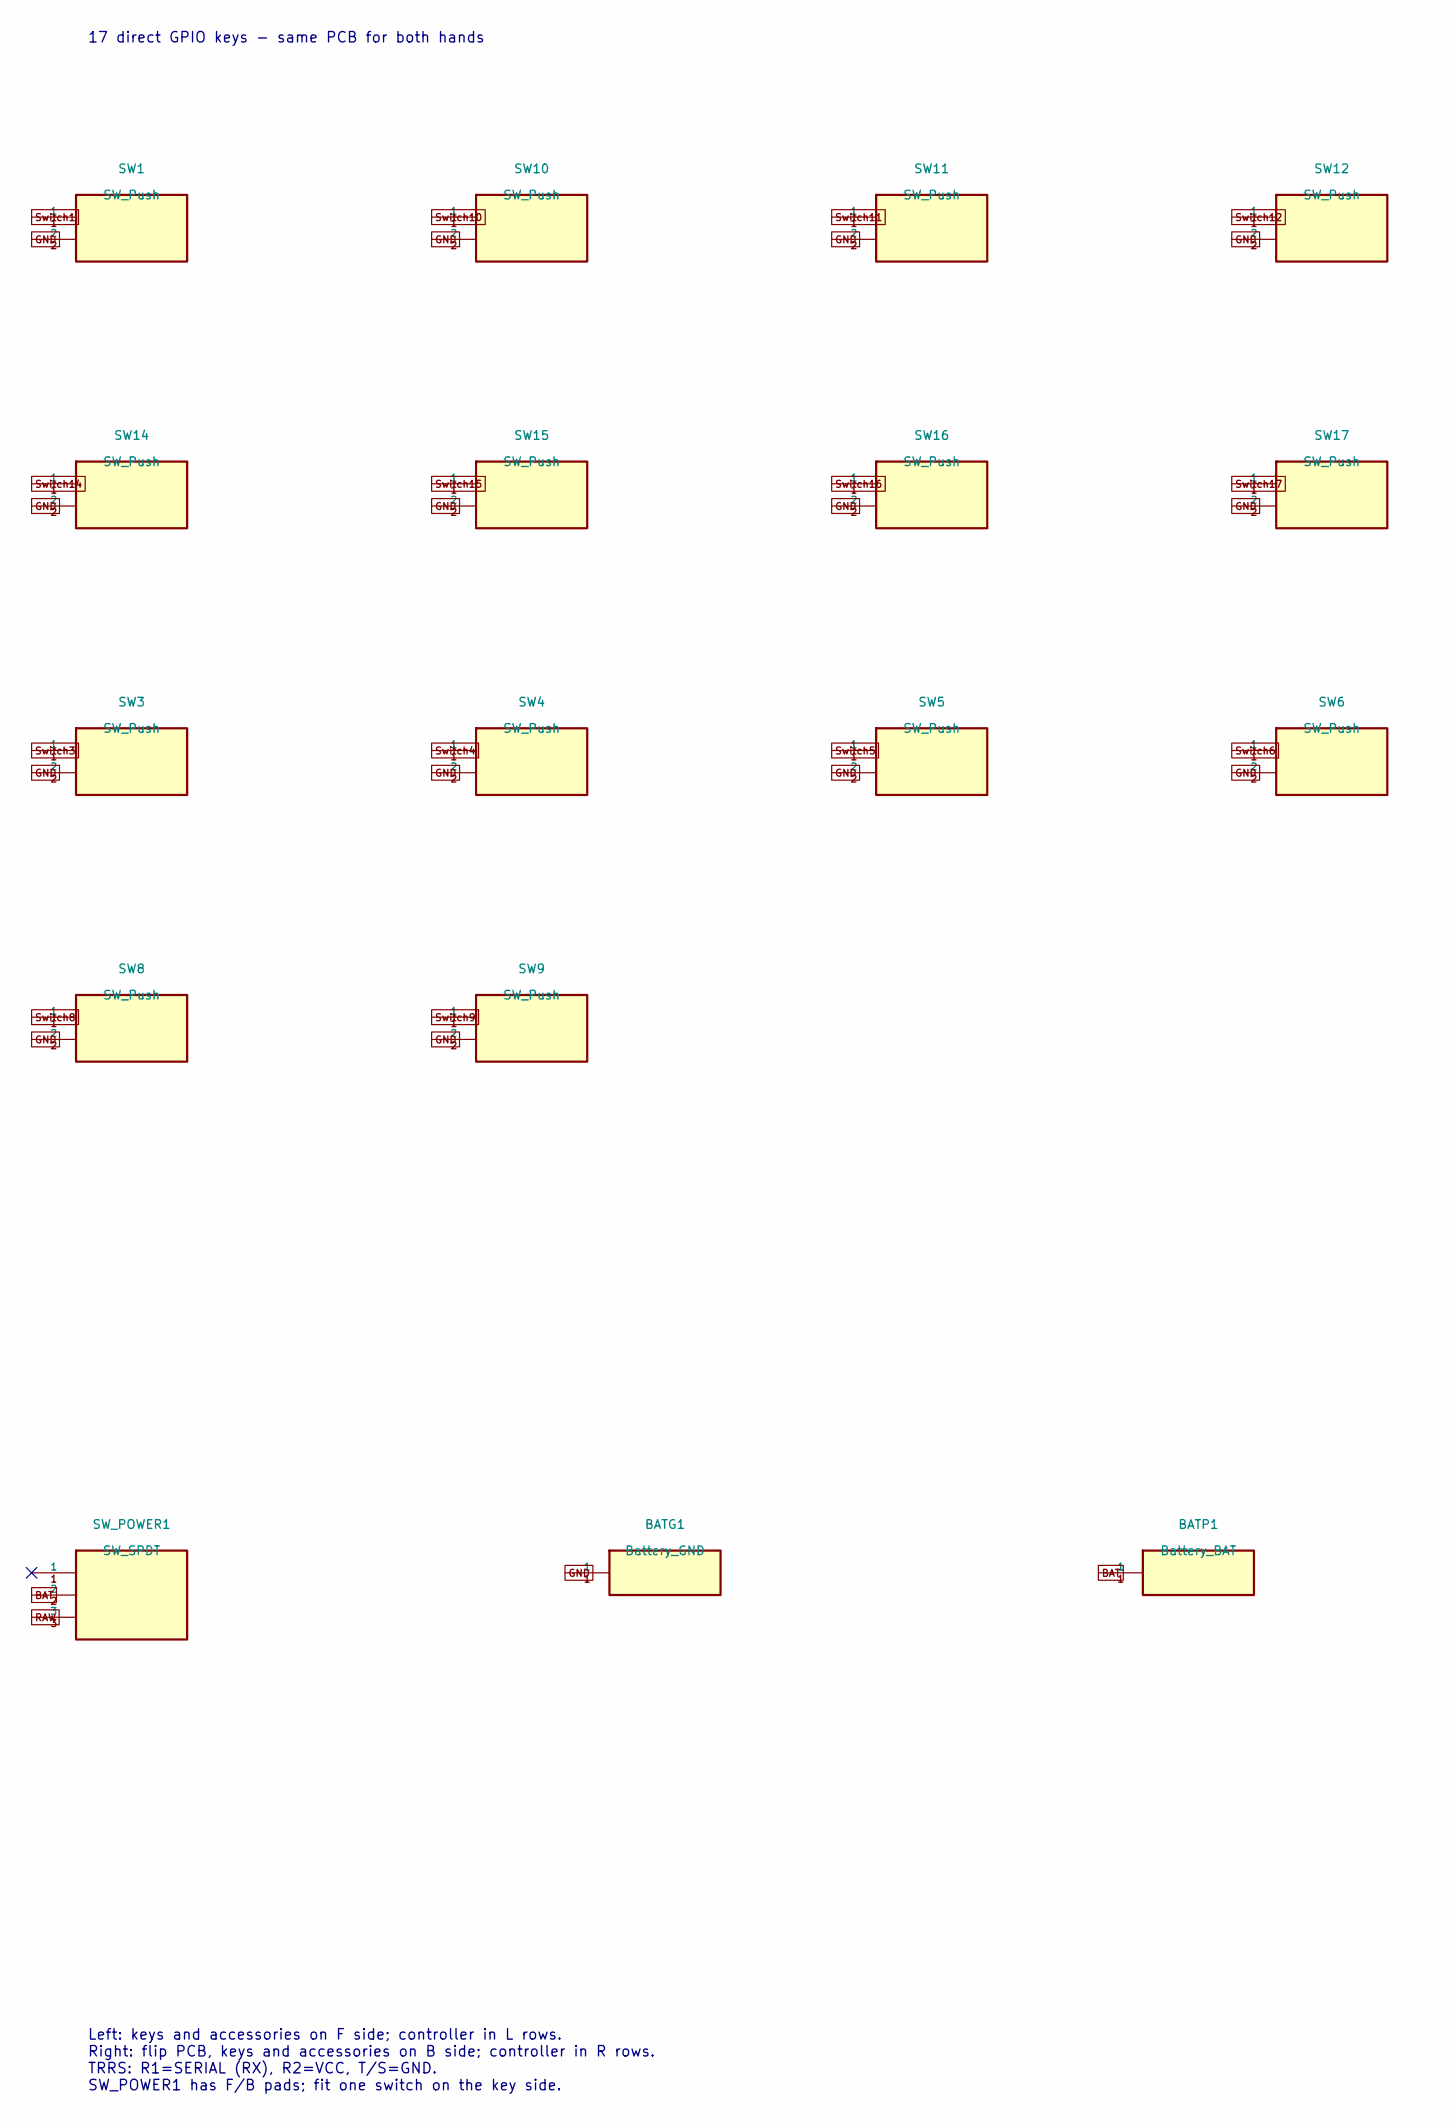
[picture p26: schematic SweepPluck.kicad_sch, SweepPluck reversible 17-key half, part in row 1, column 1]

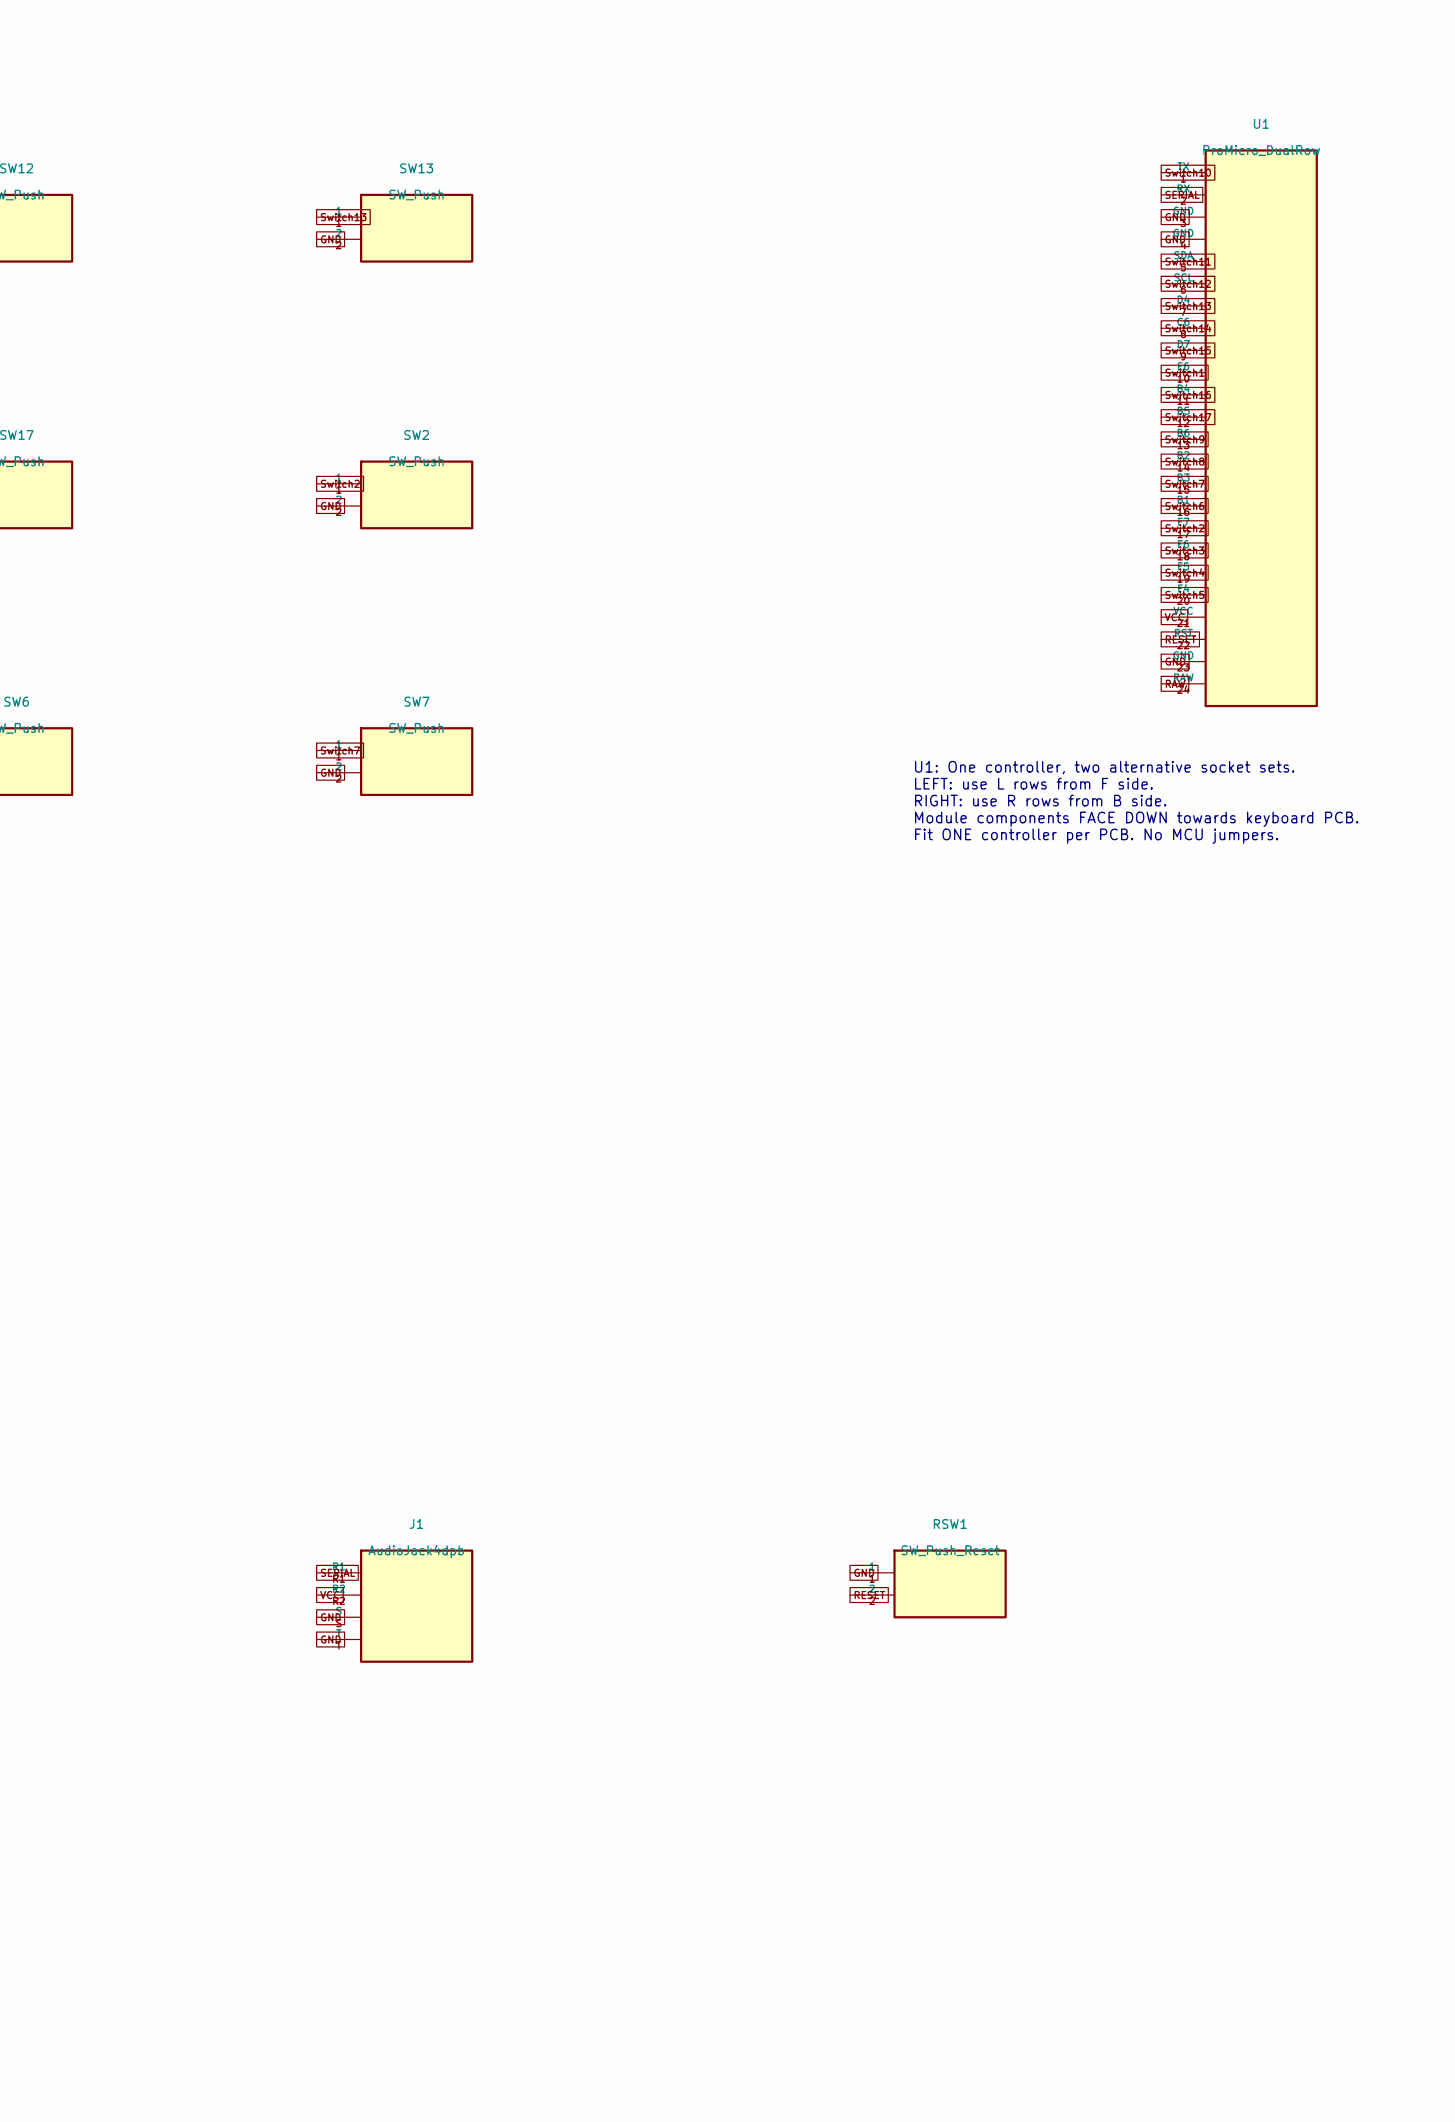
[picture p27: schematic SweepPluck.kicad_sch, SweepPluck reversible 17-key half, part in row 1, column 2]

Parts:
BATG1: Battery_GND; Battery_Pad
BATP1: Battery_BAT; Battery_Pad
J1: AudioJack4dpb; TRRS_Reversible
RSW1: SW_Push_Reset; Reset_Reversible
SW1, SW2, SW3, SW4, SW5, SW6, SW7, SW8, SW9, SW10, SW11, SW12, SW13, SW14, SW15, SW16, SW17: SW_Push; Universal_Reversible
SW_POWER1: SW_SPDT; Power_Reversible
U1: ProMicro_DualRow

Connections:
BAT: BATP1.1, SW_POWER1.2
GND: BATG1.1, J1.S, J1.T, RSW1.1, SW1.2, SW2.2, SW3.2, SW4.2, SW5.2, SW6.2, SW7.2, SW8.2, SW9.2, SW10.2, SW11.2, SW12.2, SW13.2, SW14.2, SW15.2, SW16.2, SW17.2, U1.3 (GND), U1.4 (GND), U1.23 (GND)
RAW: SW_POWER1.3, U1.24 (RAW)
RESET: RSW1.2, U1.22 (RST)
SERIAL: J1.R1, U1.2 (RX)
Switch1: SW1.1, U1.10 (E6)
Switch2: SW2.1, U1.17 (F7)
Switch3: SW3.1, U1.18 (F6)
Switch4: SW4.1, U1.19 (F5)
Switch5: SW5.1, U1.20 (F4)
Switch6: SW6.1, U1.16 (B1)
Switch7: SW7.1, U1.15 (B3)
Switch8: SW8.1, U1.14 (B2)
Switch9: SW9.1, U1.13 (B6)
Switch10: SW10.1, U1.1 (TX)
Switch11: SW11.1, U1.5 (SDA)
Switch12: SW12.1, U1.6 (SCL)
Switch13: SW13.1, U1.7 (D4)
Switch14: SW14.1, U1.8 (C6)
Switch15: SW15.1, U1.9 (D7)
Switch16: SW16.1, U1.11 (B4)
Switch17: SW17.1, U1.12 (B5)
VCC: J1.R2, U1.21 (VCC)

Notes on the sheet:
17 direct GPIO keys - same PCB for both hands
U1: One controller, two alternative socket sets. LEFT: use L rows from F side. RIGHT: use R rows from B side. Module components FACE DOWN towards keyboard PCB. Fit ONE controller per PCB. No MCU jumpers.
Left: keys and accessories on F side; controller in L rows. Right: flip PCB, keys and accessories on B side; controller in R rows. TRRS: R1=SERIAL (RX), R2=VCC, T/S=GND. SW_POWER1 has F/B pads; fit one switch on the key side.

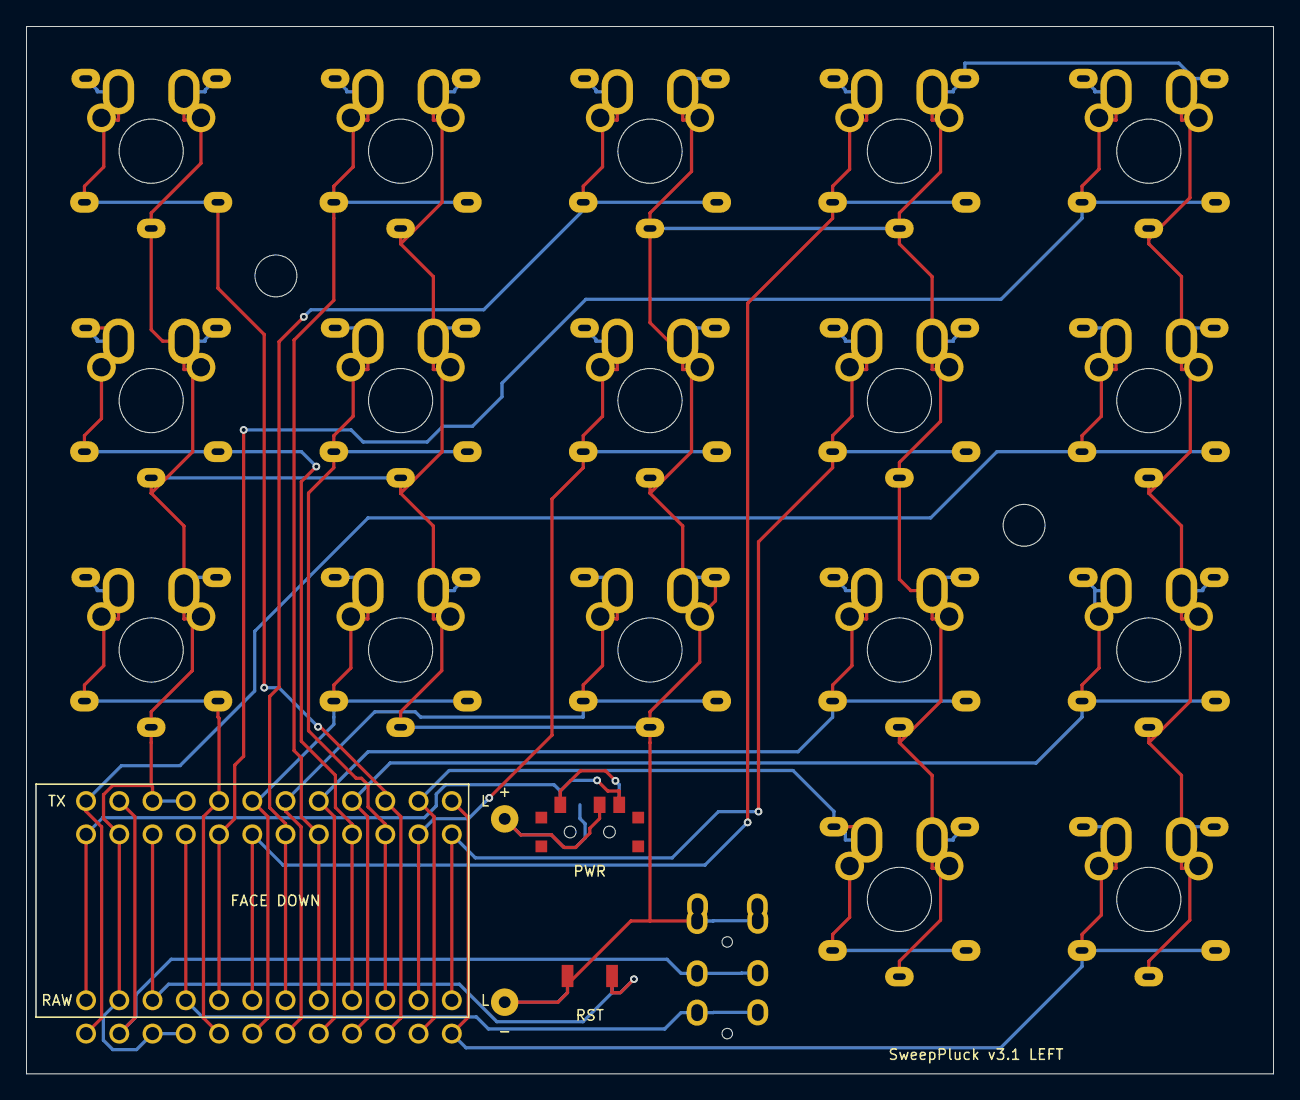
[picture p28: board SweepPluck.kicad_pcb from above]

Board: 2 copper layers, 95.2 x 80.0 mm, 25 parts (0 on the bottom side), 23 nets.

Other parts of the board:
H1, H2: MountingHole_3.2mm
