punkrocker/Keyboards/SweepPluck/tools/compact.py

"""Compatibility entry point for reversible SweepPluck v3.

The original generator is preserved in archive/SweepPluck-v2-panel.zip.
"""
from reversible import main

if __name__ == "__main__":
    main()
