punkrocker/Keyboards/(commit log)

2026-10-18 Add SweepPluck keyboard design and fabrication files
    [BoardOutline.GKO, BottomCopper.GBL, BottomSilkscreen.GBO, BottomSolderMask.GBS, NonPlated.DRL, Plated.DRL, SweepPluck-B_Cu.gbl, SweepPluck-B_Mask.gbs]
2026-10-18 Document battery and power switch soldering for both PCB faces
2026-10-18 Mark battery and power switch pads on actual PCB views
2026-10-18 Mark U1 controller soldering rows and USB orientation on PCB views
